bcsedlon/growmat-easy/doc/growmat_easy.jpg

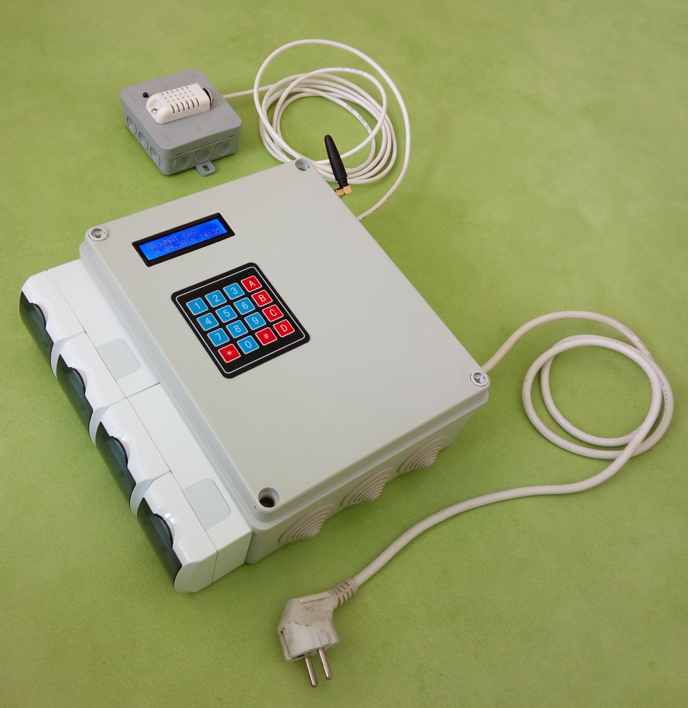
doc/growmat_easy.jpg
