bcsedlon/growmat-easy/doc/eagle/growmat_easy/growmat_easy_p1.png

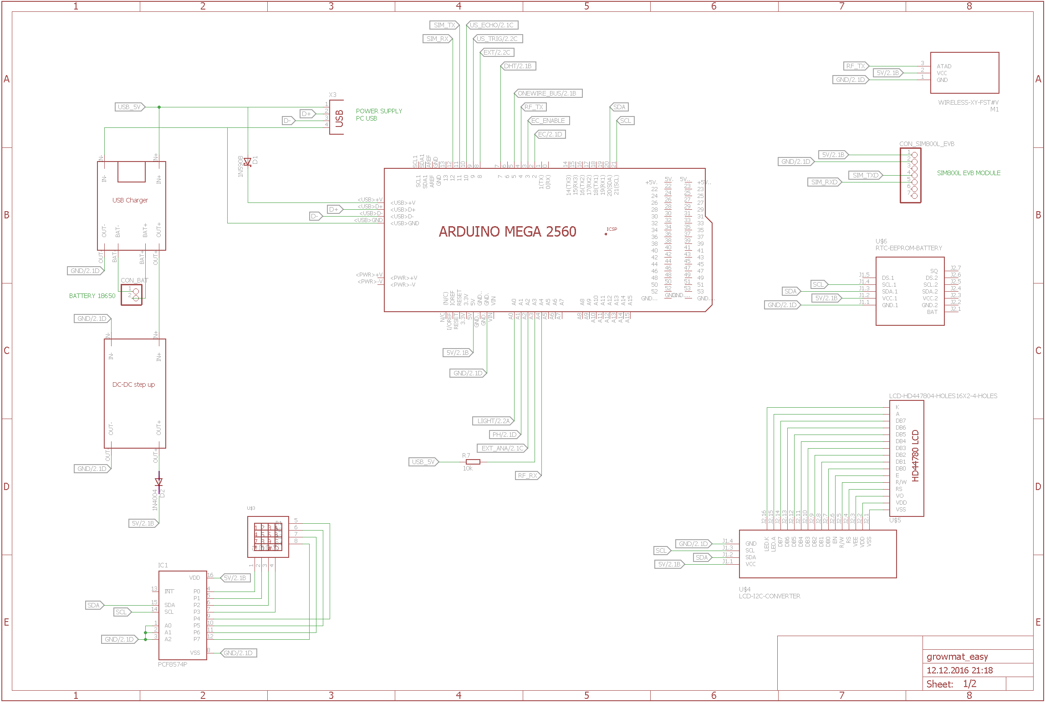
doc/eagle/growmat_easy/growmat_easy_p1.png
