bcsedlon/growmat-easy/doc/growmat_easy.xlsx

Sheet: price list
 | item | pcs | price per pcs | price total |  | sales price
growmat easy |  |  |  |  |  | 2900 | postavrobota.cz
 | box | 1 | 280 | 280 |  |  | 280 |  | hornbach
 | socket 230VAC | 2 | 120 | 240 |  |  | 240 |  | hornabch
 | arduino | 1 | 60 | 60 |  |  | 160 |  | http://www.ebay.com/itm/10Pcs-MINI-USB-Nano-V3-0-ATmega328P-CH340G-5V-16M-Micro-controller-board-Arduino-/131278739167
 | rtc | 1 | 100 | 100 |  |  | 50 |  | http://www.ebay.com/itm/251887554747
 | display | 1 | 150 | 150 |  |  | 160 |  | http://www.ebay.com/itm/Blue-Serial-IIC-I2C-TWI-2004-204-20X4-Character-LCD-Module-Display-For-Arduino-/381375068233
 | keypad | 1 | 50 | 50 |  |  | 40 |  | http://www.ebay.com/itm/4-x-4-AVR-16-Key-Matrix-Array-For-Arduino-HOT-Membrane-Switch-Keypad-Keyboard-/331913224309
 | i2c expander | 3 | 50 | 150 |  |  | 100 | ? | http://www.ebay.com/itm/PCF8574-IO-Expansion-Board-I-O-Expander-I2C-Bus-Evaluation-Development-Module-/400453349150
 | relay | 1 | 50 | 50 |  |  | 150 |  | http://www.ebay.com/itm/4-Four-Channel-Relay-Module-DC-5V-Optocoupler-For-Arduino-PIC-ARM-AVR-DSP-/281686248144
 | contactor 20A | 1 | 350 | 350 |  |  | 350 |  | gme
 | dps | 1 | 200 | 200 |  |  | 75
 |  |  |  | 0
 |  |  |  | 0 |  |  | 50 | 18650
 |  |  |  | 0 |  |  | 20 | drzak
 |  |  |  | 0 |  |  | 45
 | power suplly | 1 | 250 | 250 |  |  | 35
 |  |  |  | 0 |  |  |  |  | http://www.ebay.com/itm/281783236684?_trksid=p2057872.m2749.l2649&ssPageName=STRK%3AMEBIDX%3AIT
 |  |  |  | 0 | 1880
ups + gsm |  |  |  |  |  | 3900
 | power suplly + charger | 1 | 399 | 399 |  |  |  |  | http://www.t-led.cz/ups-zdroj-12v-35w-s-nabijenim
 | battery 12V | 1 | 300 | 300 |  |  |  |  | gme
 | 12V to 5V converter | 0 | 71 | 0
 |  |  |  | 0
 |  |  |  | 0
 |  |  |  | 0
 | sim8000l | 1 | 300 | 300 |  |  | 350 |  | http://www.ebay.com/itm/SIM800L-GPRS-GSM-Module-Board-Quadband-QUAD-BAND-Antenna-for-MCU-Arduino-/281743051042
 |  |  |  | 0
 |  |  |  | 0
 |  |  |  | 0 | 999
 | total |  |  | 2879 |  |  | 2105
modul
 | box | 1 | 30 | 30 |  |  | 30 |  | hornbach
 | AM2302 | 1 | 125 | 125 |  |  | 200 | ?
 | led & etc | 1 | 20 | 20 |  |  | 20
 |  |  |  | 0
 |  |  |  | 0 | 175
 | total |  |  | 175 |  |  | 250
 |  |  |  |  |  |  | 2500 | nakup easy gsm
 |  |  |  |  |  |  | 500 | dane + fix
 |  |  |  |  |  |  | 1000 | prace 3h?
 |  |  |  |  |  |  | 4000 | prodej
 |  |  |  |  |  |  | 0 | rozdil
DHT22
 | DHT22 | 0 | 80 | 0
 | AM2302 | 1 | 125 | 125 |  |  |  |  | http://www.ebay.com/itm/201442918588
DS18B20
 | DS18B20 | 1 | 50 | 50 |  |  |  |  | http://www.ebay.com/itm/181171267370
HC-SR06
 | HC-SR06 | 1 | 30 | 30 |  |  |  |  | http://www.ebay.com/itm/400985326881
PH
 | PH0-14 | 1 | 650 | 650 |  |  |  |  | http://www.ebay.com/itm/271985715879
CO2
 | MG-811 | 1 | 960 | 960 |  |  |  |  | http://www.ebay.com/itm/SainSmart-MG-811-MG811-CO2-Carbon-Dioxide-Sensor-For-Arduino-UNO-R3-Raspberry-Pi-/301191399526
PIR
 | HC SR501 | 1 | 30 | 30 |  |  |  |  | http://www.ebay.com/itm/HC-SR501-Infrared-PIR-Motion-Sensor-Module-for-Arduino-Raspberry-pi-HCSR501-/151857503916

Sheet: growmat_easy_hydro
item | pcs | price per pcs | price total | coeficient | price | sales price | source | vat | descr | link
box | 1 | 280 | 280 | 1 | 280 |  | cz | 1 |  | hornbach
433MHz socket | 1 | 700 | 700 | 1 | 700 |  | cz | 1 |  | http://www.giganto.cz/elektronika/dalkove-ovladane-bezdratove-zasuvky-3600w
433MHz tx | 1 | 40 | 40 | 1 | 40 |  | cz | 0 |  | https://www.postavrobota.cz/Vysilac-433MHz-ASK-antena-d663.htm
display | 1 | 160 | 160 | 1 | 160 |  | cz | 0 |  | https://www.postavrobota.cz/I2C-LCD-displej-znakovy-16x2-modry-d333.htm
keyboard | 1 | 40 | 40 | 1 | 40 |  | cz | 0 |  | https://www.postavrobota.cz/Membranova-klavesnice-4x3-samolepici-d137.htm
i2c expander | 1 | 50 | 50 | 2 | 100 |  | ebay |  |  | http://www.ebay.com/itm/PCF8574-PCF8574T-I2C-8-Bit-IO-GPIO-Expander-Module-for-Arduino-Raspberry-Pi-UK-/272432637606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
arduino mega | 1 | 400 | 400 | 1 | 400 |  | cz | 0 |  | https://www.postavrobota.cz/Dccduino-Mega-ATmega2560-Arduino-kompatibilni-d100.htm
battery | 1 | 50 | 50 | 2 | 100 |  | ebay |  |  | http://www.ebay.com/itm/4pcs-3-7V-18650-9900mah-Li-ion-Rechargeable-Battery-For-LED-Flashlight-Torch-LO-/161933546105
charger | 1 | 45 | 45 | 1 | 45 |  | cz | 0 |  | https://www.postavrobota.cz/Mini-nabijecka-Li-ion-Li-po-clanku-s-ochranou-baterie-d10.htm
dc step-up | 1 | 35 | 35 | 1 | 35 |  | cz | 0 |  | https://www.postavrobota.cz/Mini-nastavitelny-zdroj-zvysujici-napeti-2A-d136.htm
gsm | 1 | 300 | 300 | 2 | 600 |  | ebay |  |  | http://www.ebay.com/itm/SIM800L-GPRS-GSM-SIM-Board-Quadband-QUAD-BAND-L-shape-Antenna-for-Arduino-/281958541036
ph probe | 1 | 700 | 700 | 2 | 1400 |  | ebay |  |  | http://www.ebay.com/itm/Liquid-PH0-14-Value-Detect-Sensor-Module-PH-Electrode-Probe-BNC-for-Arduino-G-/262617141991
ph modul | 1 | 0 | 0 | 1 | 0
ec probe | 1 | 700 | 700 | 2 | 1400 |  | ebay |  |  | http://www.ebay.com/itm/E201WM-Conductivity-COND-EC-electrode-Conductivity-sensor-probe-BNC-connector-/141936907599
ec modul | 1 | 100 | 100 | 1 | 100 |  | cz | 1 |  | gsm
ec dc-dc isolated | 1 | 100 | 100 | 1 | 100 |  | cz | 0 |  | https://www.postavrobota.cz/DC-DC-5V-5V-izolovany-zdroj-1W-d279.htm
thermo/humidyty meter air | 1 | 150 | 150 | 2 | 300 |  | ebay
light sensor | 1 | 50 | 50 | 1 | 50 |  | cz | 1 |  | gsm
thermometer water | 1 | 150 | 150 | 1 | 150 |  | cz | 0 |  | https://www.postavrobota.cz/Digitalni-teplotni-sonda-DS18B20-2m-d370.htm
ultrasonic distance meter | 1 | 200 | 200 | 2 | 400 |  | ebay |  |  | http://www.ebay.com/itm/Ultrasonic-Module-Distance-Measuring-Transducer-Sensor-Waterproof-Perfect-/272041782549
level switch | 1 | 100 | 100 | 1 | 100
usb cable | 1 | 50 | 50 | 1 | 50
power source | 1 | 100 | 100 | 1 | 100
rtc | 1 | 50 | 50 | 1 | 50 |  |  |  |  | https://www.postavrobota.cz/RTC-modul-realneho-casu-DS1307-baterie-d123.htm
pcb ps | 1 |  | 0 | 1 | 0
pcb ec | 1 |  | 0 | 1 | 0
pcb ? | 1 |  | 0 | 1 | 0
esp8266 | 1 | 140 | 140 | 1 | 140 |  | cz | 0 |  | https://www.postavrobota.cz/WiFi-RS232-AT-modul-ESP8266-2-4GHz-SoC-d159.htm
sim800l | 1 | 300 | 300 | 1 | 300 |  | ebay |  |  | http://www.ebay.com/itm/SIM800L-GPRS-GSM-SIM-Board-Quadband-QUAD-BAND-L-shape-Antenna-for-Arduino-/201647406545
 | 1 |  | 0 | 1 | 0
 | 1 |  | 0 | 1 | 0
 | 1 |  | 0 | 1 | 0
 | 1 |  | 0 | 1 | 0
 | 1 |  | 0 | 1 | 0
 | 1 |  | 0 | 1 | 0
 | 1 |  | 0 | 1 | 0
 | 1 |  | 0 | 1 | 0
 | 1 |  | 0 | 1 | 0
 | 1 |  | 0 | 1 | 0
 | 1 |  | 0 | 1 | 0
 | 1 |  | 0 | 1 | 0
 | 1 |  | 0 | 1 | 0
 | 1 |  | 0 | 1 | 0
 |  |  | 4990 |  | 7140
