bcsedlon/growmat-easy/(list of files, drawings)

Other design files:
doc/hw/growmat_easy_05dm2.fzz
doc/hw/growmat_easy_rev2a.fzz
doc/hw/growmat_easy_rev2b.fzz
