bcsedlon/growmat-easy/doc/eagle/ec/ec.brd

## EAGLE design doc/eagle/ec/ec.brd (2016-12-14)

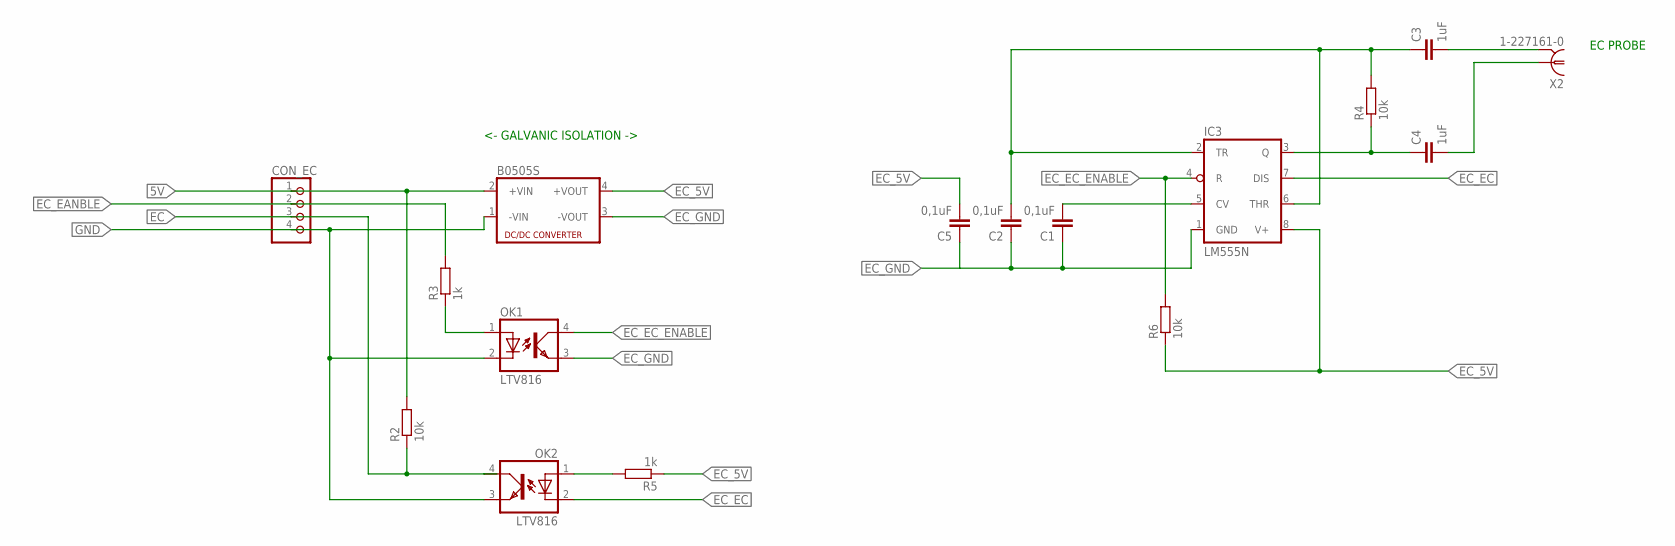
[picture p10: schematic ec.sch]

Parts:
B0505S: NME
C1, C2, C5: 0,1uF; C050-024X044
C3, C4: 1uF; C050-024X044
CON_EC: PINHD-1X4; 1X04
IC3: LM555N; DIL08
OK1, OK2: LTV816; DIL04
R2, R4, R6: 10k; 0207/10
R3, R5: 1k; 0207/10
X2: 1-227161-0; AMP_227161

Connections:
5V: B0505S.2 (+VIN), CON_EC.1, R2.2
EC: CON_EC.3, OK2.4 (COL), R2.1
EC_5V: B0505S.4 (+VOUT), C5.2, IC3.8 (V+), R5.1, R6.1
EC_EANBLE: CON_EC.2, R3.2
EC_EC: IC3.7 (DIS), OK2.2 (C)
EC_EC_ENABLE: IC3.4 (R), OK1.4 (COL), R6.2
EC_GND: B0505S.3 (-VOUT), C1.1, C2.1, C5.1, IC3.1 (GND), OK1.3 (EMIT)
GND: B0505S.1 (-VIN), CON_EC.4, OK1.2 (C), OK2.3 (EMIT)
unnamed: C1.2, IC3.5 (CV)
unnamed: C3.2, X2.2
unnamed: C2.2, C3.1, IC3.2 (TR), IC3.6 (THR), R4.2
unnamed: OK1.1 (A), R3.1
unnamed: C4.1, IC3.3 (Q), R4.1
unnamed: OK2.1 (A), R5.2
unnamed: C4.2, X2.1

Notes on the sheet:
EC PROBE
<- GALVANIC ISOLATION ->

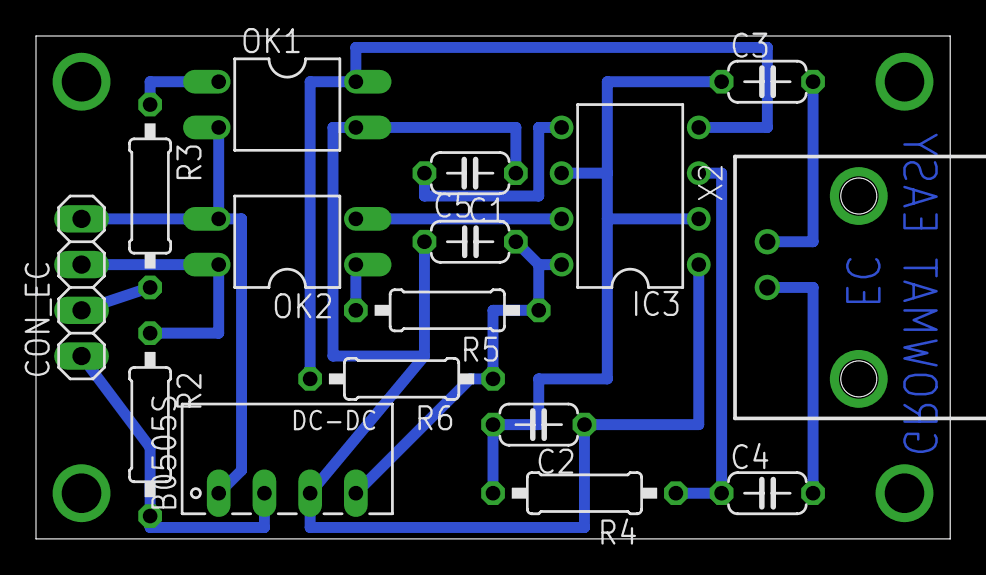
[picture p11: board ec.brd from above]

Board: 2 copper layers, 50.8 x 27.9 mm, 16 parts (0 on the bottom side), 15 nets.
