bcsedlon/growmat-easy/doc/eagle/ps/ps.brd

## EAGLE design doc/eagle/ps/ps.brd (2016-12-14)

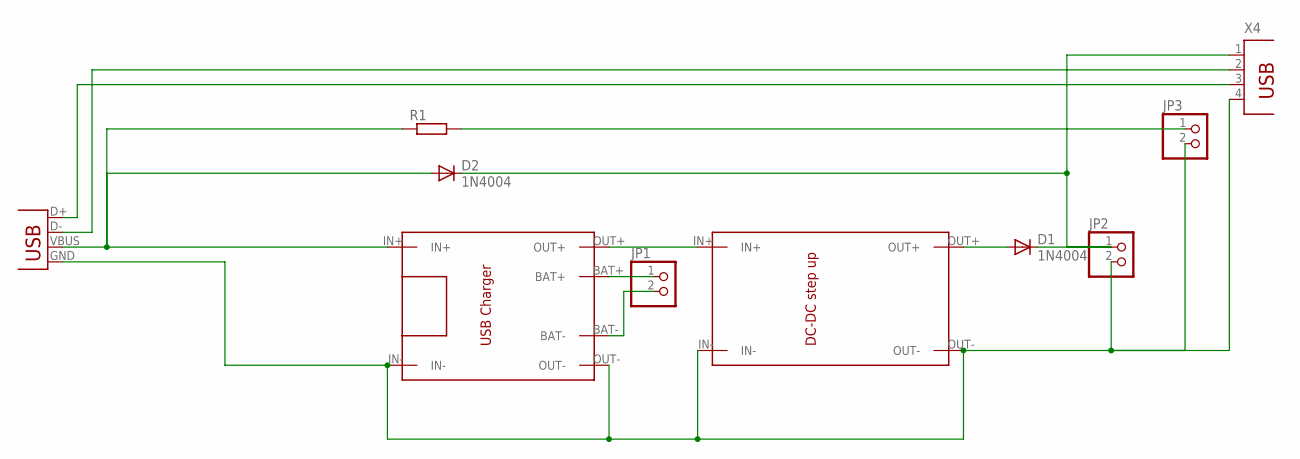
[picture p12: schematic ps.sch]

Parts:
D1, D2: 1N4004; DO41-10
JP1, JP2, JP3: PINHD-1X2; 1X02
R1: R-EU_0204/7; 0204/7
U$1: TP4056
U$2: DC-DC_STEPUP
X3: USBPTH; USB-B-PTH
X4: PN87520

Connections:
unnamed: D2.A, R1.1, U$1.IN+, X3.VBUS
unnamed: U$1.OUT+, U$2.IN+
unnamed: JP1.1, U$1.BAT+
unnamed: JP1.2, U$1.BAT-
unnamed: D1.A, U$2.OUT+
unnamed: D1.C, D2.C, JP2.1, X4.1
unnamed: JP2.2, JP3.2, U$1.IN-, U$1.OUT-, U$2.IN-, U$2.OUT-, X3.GND, X4.4
unnamed: JP3.1, R1.2
unnamed: X3.D+, X4.3
unnamed: X3.D-, X4.2

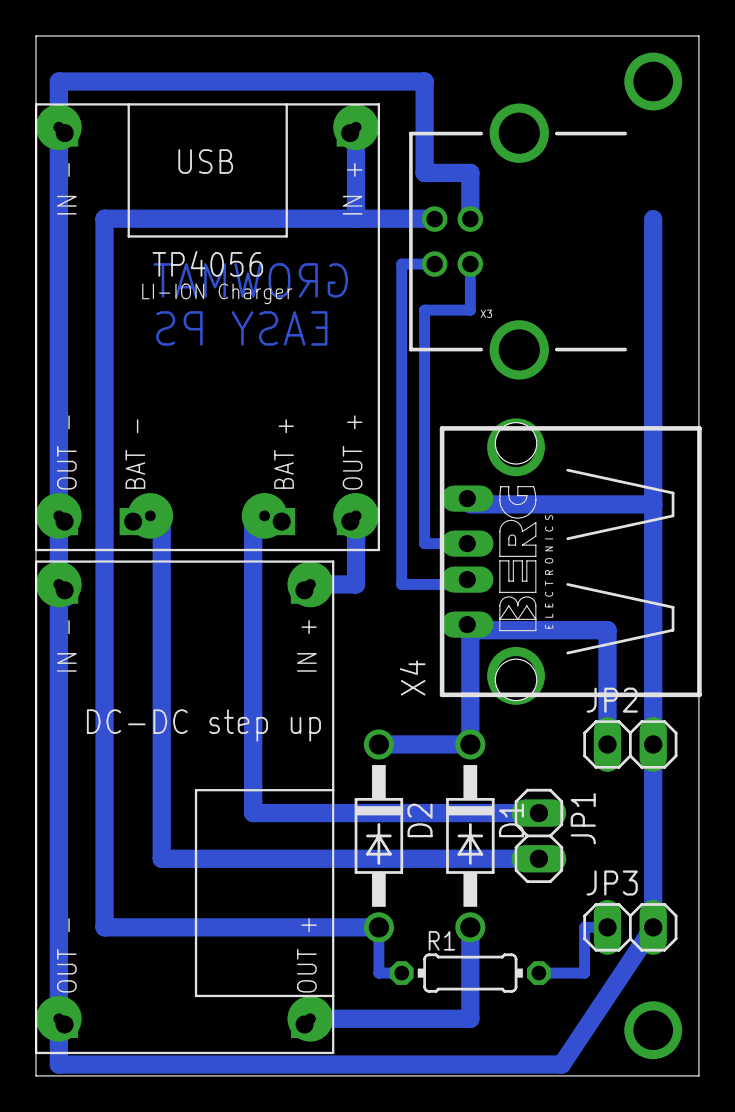
[picture p13: board ps.brd from above]

Board: 2 copper layers, 36.8 x 57.8 mm, 10 parts (0 on the bottom side), 10 nets.
