bcsedlon/growmat-easy/doc/eagle/ps/ps2x2.brd

## EAGLE design doc/eagle/ps/ps2x2.brd (2017-01-24)

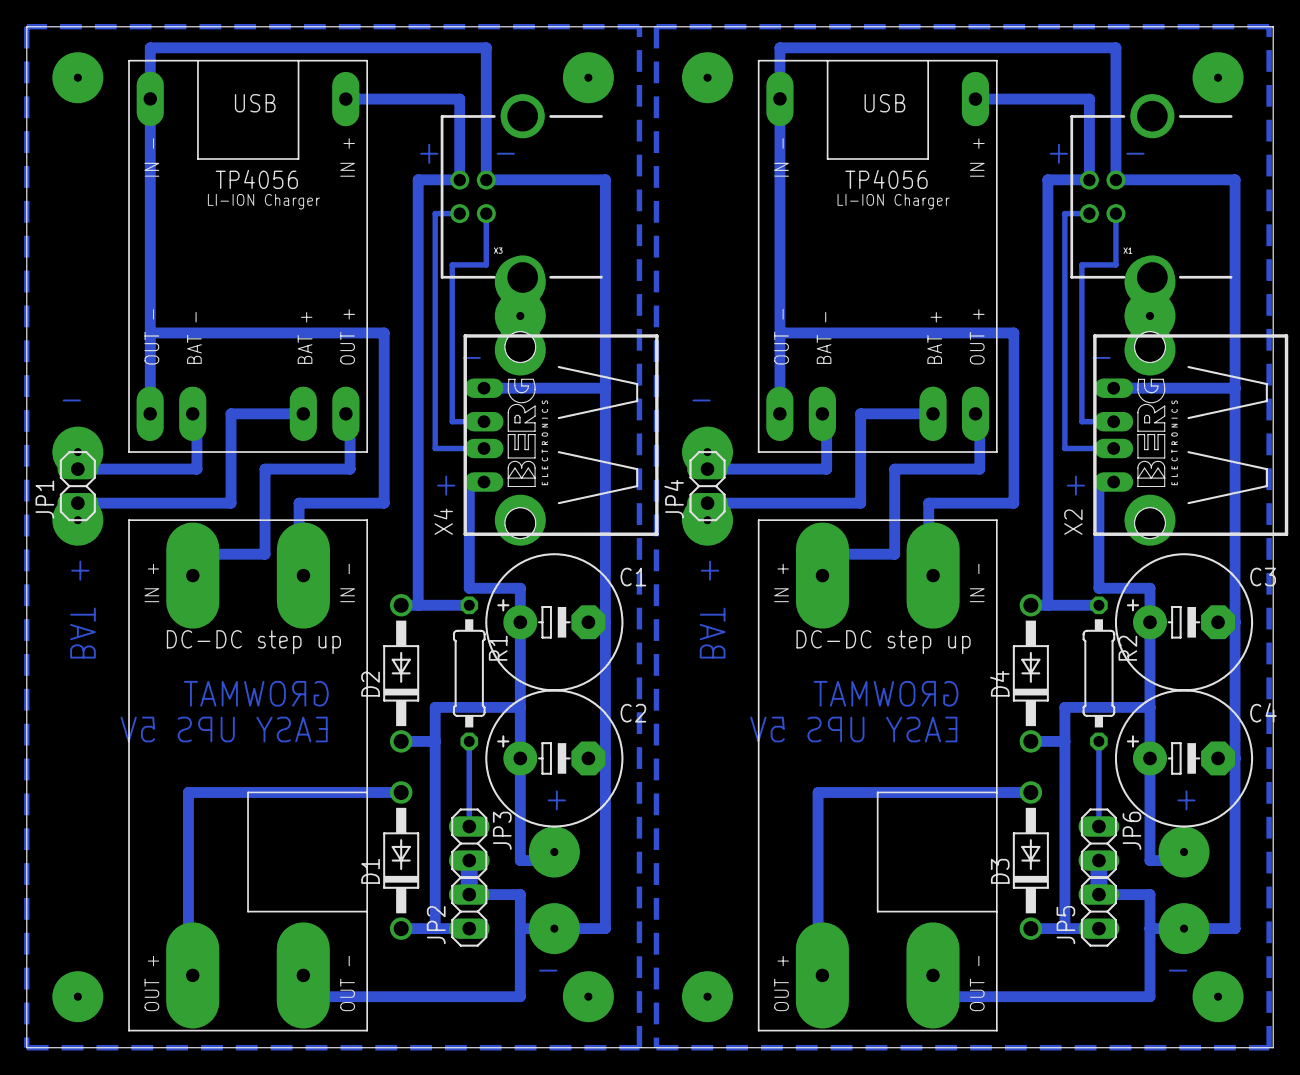
[picture p14: board ps2x2.brd from above]

Board: 2 copper layers, 93.0 x 76.2 mm, 24 parts (0 on the bottom side), 20 nets.

Parts:
C1, C2, C3, C4: E5-10,5
D1, D2, D3, D4: 1N4004; DO41-10
JP1, JP2, JP3, JP4, JP5, JP6: 1X02
R1, R2: 0207/10
U$1, U$2: TP4056
U$3, U$4: DC-DC_STEPUP
X1, X3: USBPTH; USB-B-PTH
X2, X4: PN87520

Connections:
unnamed: D2.A, R1.1, U$1.IN+, X3.VBUS
unnamed: U$1.OUT+, U$3.IN+
unnamed: C1.-, C2.-, JP2.2, JP3.2, U$1.IN-, U$1.OUT-, U$3.IN-, U$3.OUT-, X3.GND, X4.4
unnamed: JP1.1, U$1.BAT+
unnamed: JP1.2, U$1.BAT-
unnamed: D1.A, U$3.OUT+
unnamed: C1.+, C2.+, D1.C, D2.C, JP2.1, X4.1
unnamed: D4.A, R2.1, U$2.IN+, X1.VBUS
unnamed: U$2.OUT+, U$4.IN+
unnamed: JP3.1, R1.2
unnamed: X3.D+, X4.3
unnamed: X3.D-, X4.2
unnamed: JP4.1, U$2.BAT+
unnamed: JP4.2, U$2.BAT-
unnamed: D3.A, U$4.OUT+
unnamed: C3.+, C4.+, D3.C, D4.C, JP5.1, X2.1
unnamed: JP6.1, R2.2
unnamed: X1.D+, X2.3
unnamed: X1.D-, X2.2
unnamed: C3.-, C4.-, JP5.2, JP6.2, U$2.IN-, U$2.OUT-, U$4.IN-, U$4.OUT-, X1.GND, X2.4
