bcsedlon/growmat-easy/doc/eagle/ec/ec3-ps2-100cm2.brd

## EAGLE design doc/eagle/ec/ec3-ps2-100cm2.brd (2016-12-14)

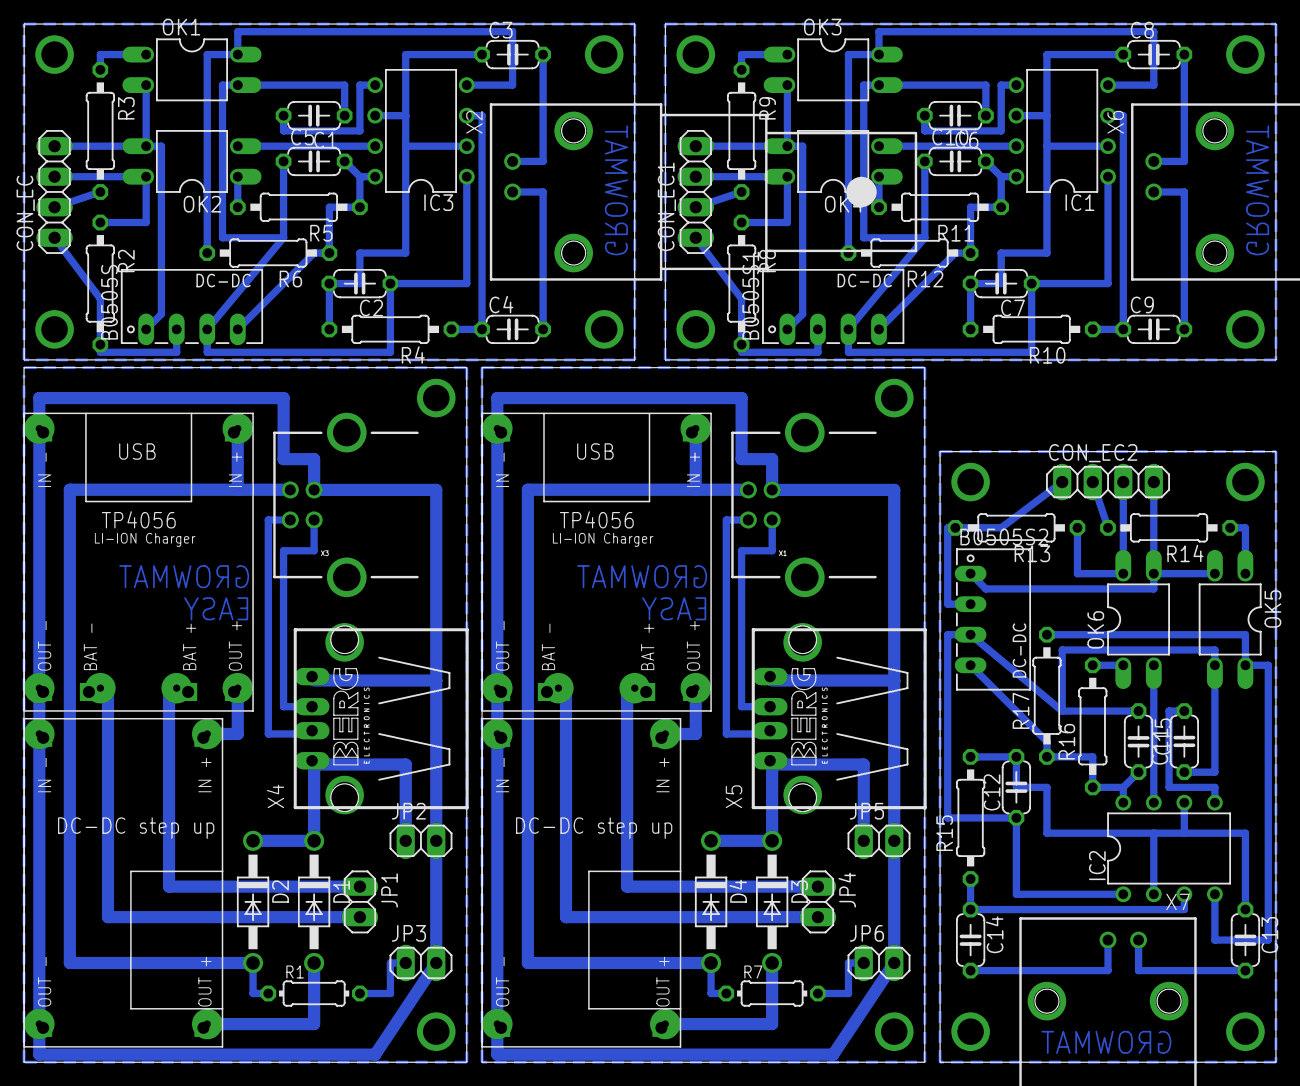
[picture p15: board ec3-ps2-100cm2.brd from above]

Board: 2 copper layers, 104.1 x 86.4 mm, 68 parts (0 on the bottom side), 65 nets.

Parts:
B0505S, B0505S1, B0505S2: NME
C1, C2, C5, C6, C7, C10, C11, C12, C15: 0,1uF; C050-024X044
C3, C4, C8, C9, C13, C14: 1uF; C050-024X044
CON_EC, CON_EC1, CON_EC2: 1X04
D1, D2, D3, D4: 1N4004; DO41-10
IC1, IC2, IC3: LM555N; DIL08
JP1, JP2, JP3, JP4, JP5, JP6: 1X02
OK1, OK2, OK3, OK4, OK5, OK6: LTV816; DIL04
R1, R7: 0204/7
R2, R4, R6, R8, R10, R12, R13, R15, R17: 10k; 0207/10
R3, R5, R9, R11, R14, R16: 1k; 0207/10
U$1, U$3: TP4056
U$2, U$4: DC-DC_STEPUP
X1, X3: USBPTH; USB-B-PTH
X2, X6, X7: 1-227161-0; AMP_227161
X4, X5: PN87520

Connections:
5V: B0505S.2, CON_EC.1, R2.2
5V1: B0505S1.2, CON_EC1.1, R8.2
5V2: B0505S2.2, CON_EC2.1, R13.2
EC: CON_EC.3, OK2.4, R2.1
EC1: CON_EC1.3, OK4.4, R8.1
EC2: CON_EC2.3, OK6.4, R13.1
EC_5V: B0505S.4, C5.2, IC3.8, R5.1, R6.1
EC_5V1: B0505S1.4, C10.2, IC1.8, R11.1, R12.1
EC_5V2: B0505S2.4, C15.2, IC2.8, R16.1, R17.1
EC_EANBLE: CON_EC.2, R3.2
EC_EANBLE1: CON_EC1.2, R9.2
EC_EANBLE2: CON_EC2.2, R14.2
EC_EC: IC3.7, OK2.2
EC_EC1: IC1.7, OK4.2
EC_EC2: IC2.7, OK6.2
EC_EC_ENABLE: IC3.4, OK1.4, R6.2
EC_EC_ENABLE1: IC1.4, OK3.4, R12.2
EC_EC_ENABLE2: IC2.4, OK5.4, R17.2
EC_GND: B0505S.3, C1.1, C2.1, C5.1, IC3.1, OK1.3
EC_GND1: B0505S1.3, C6.1, C7.1, C10.1, IC1.1, OK3.3
EC_GND2: B0505S2.3, C11.1, C12.1, C15.1, IC2.1, OK5.3
GND: B0505S.1, CON_EC.4, OK1.2, OK2.3
GND1: B0505S1.1, CON_EC1.4, OK3.2, OK4.3
GND2: B0505S2.1, CON_EC2.4, OK5.2, OK6.3
unnamed: D2.A, R1.1, U$1.IN+, X3.VBUS
unnamed: U$1.OUT+, U$2.IN+
unnamed: JP2.2, JP3.2, U$1.IN-, U$1.OUT-, U$2.IN-, U$2.OUT-, X3.GND, X4.4
unnamed: JP1.1, U$1.BAT+
unnamed: JP1.2, U$1.BAT-
unnamed: D1.A, U$2.OUT+
unnamed: D1.C, D2.C, JP2.1, X4.1
unnamed: C1.2, IC3.5
unnamed: D4.A, R7.1, U$3.IN+, X1.VBUS
unnamed: JP3.1, R1.2
unnamed: X3.D+, X4.3
unnamed: X3.D-, X4.2
unnamed: U$3.OUT+, U$4.IN+
unnamed: JP4.1, U$3.BAT+
unnamed: JP4.2, U$3.BAT-
unnamed: D3.A, U$4.OUT+
unnamed: D3.C, D4.C, JP5.1, X5.1
unnamed: JP6.1, R7.2
unnamed: X1.D+, X5.3
unnamed: X1.D-, X5.2
unnamed: JP5.2, JP6.2, U$3.IN-, U$3.OUT-, U$4.IN-, U$4.OUT-, X1.GND, X5.4
unnamed: OK3.1, R9.1
unnamed: C6.2, IC1.5
unnamed: C7.2, C8.1, IC1.2, IC1.6, R10.2
unnamed: C3.2, X2.2
unnamed: C2.2, C3.1, IC3.2, IC3.6, R4.2
unnamed: OK1.1, R3.1
unnamed: C4.1, IC3.3, R4.1
unnamed: OK2.1, R5.2
unnamed: C4.2, X2.1
unnamed: C9.1, IC1.3, R10.1
unnamed: OK4.1, R11.2
unnamed: C8.2, X6.2
unnamed: C9.2, X6.1
unnamed: OK5.1, R14.1
unnamed: C11.2, IC2.5
unnamed: C12.2, C13.1, IC2.2, IC2.6, R15.2
unnamed: C14.1, IC2.3, R15.1
unnamed: OK6.1, R16.2
unnamed: C13.2, X7.2
unnamed: C14.2, X7.1
