bcsedlon/growmat-easy/(commit log)

2016-10-05 remove debug Serial.print
2016-10-09 initial commit in eclipse with arduino plugin
    [growmat_easy.xlsx]
2016-10-16 demo_1 output pin control
2016-10-16 fix vent temp default
    [growmat_easy.ino]
2016-10-22 add external alarm, rename vent to fan
2016-10-22 add hw drawings
    [growmat_easy_05dm2.fzz]
2016-10-24 save controlMode from SMS, add PCB
    [growmat_easy_05dm2.fzz]
2016-11-06 add banner, pcb rev2
    [growmat_easy_rev2a.fzz, growmat_easy_rev2b.fzz]
2016-11-20 cannafest 2016, nano
    [growmat_easy.xlsx]
2016-11-28 fix rf cmd, add rf sniffer
    [RF433.cpp, RF433.h, growmat_easy.ino, rf_sniffer.ino]
2016-12-07 add DS18B20 temp sensor, cmd from serial
    [growmat_easy.xlsx]
2016-12-14 eagle files
    [ec.brd, ec.sch, ec1-ps2-75cm2.brd, ec3-ps2-100cm2.brd, growmat_easy.sch, ps.brd, ps.sch]
2017-01-24 add power source 2 (eagle)
    [growmat_easy.xlsx, ps2.sch, ps2x2.brd]
2017-06-15 change i2c keypad addr, 1+A reset display, change light alarms delay, watchdog test
    [growmat_easy.ino]
2017-08-09 sn 0001 / 0002, fix (night) temperature
    [growmat_easy.ino]
